labtel-urjc/ardusense/ArduSense PCB Design/ArduSense_V0_3_5.brd

## EAGLE design ArduSense PCB Design/ArduSense_V0_3_5.brd (2018-04-27)

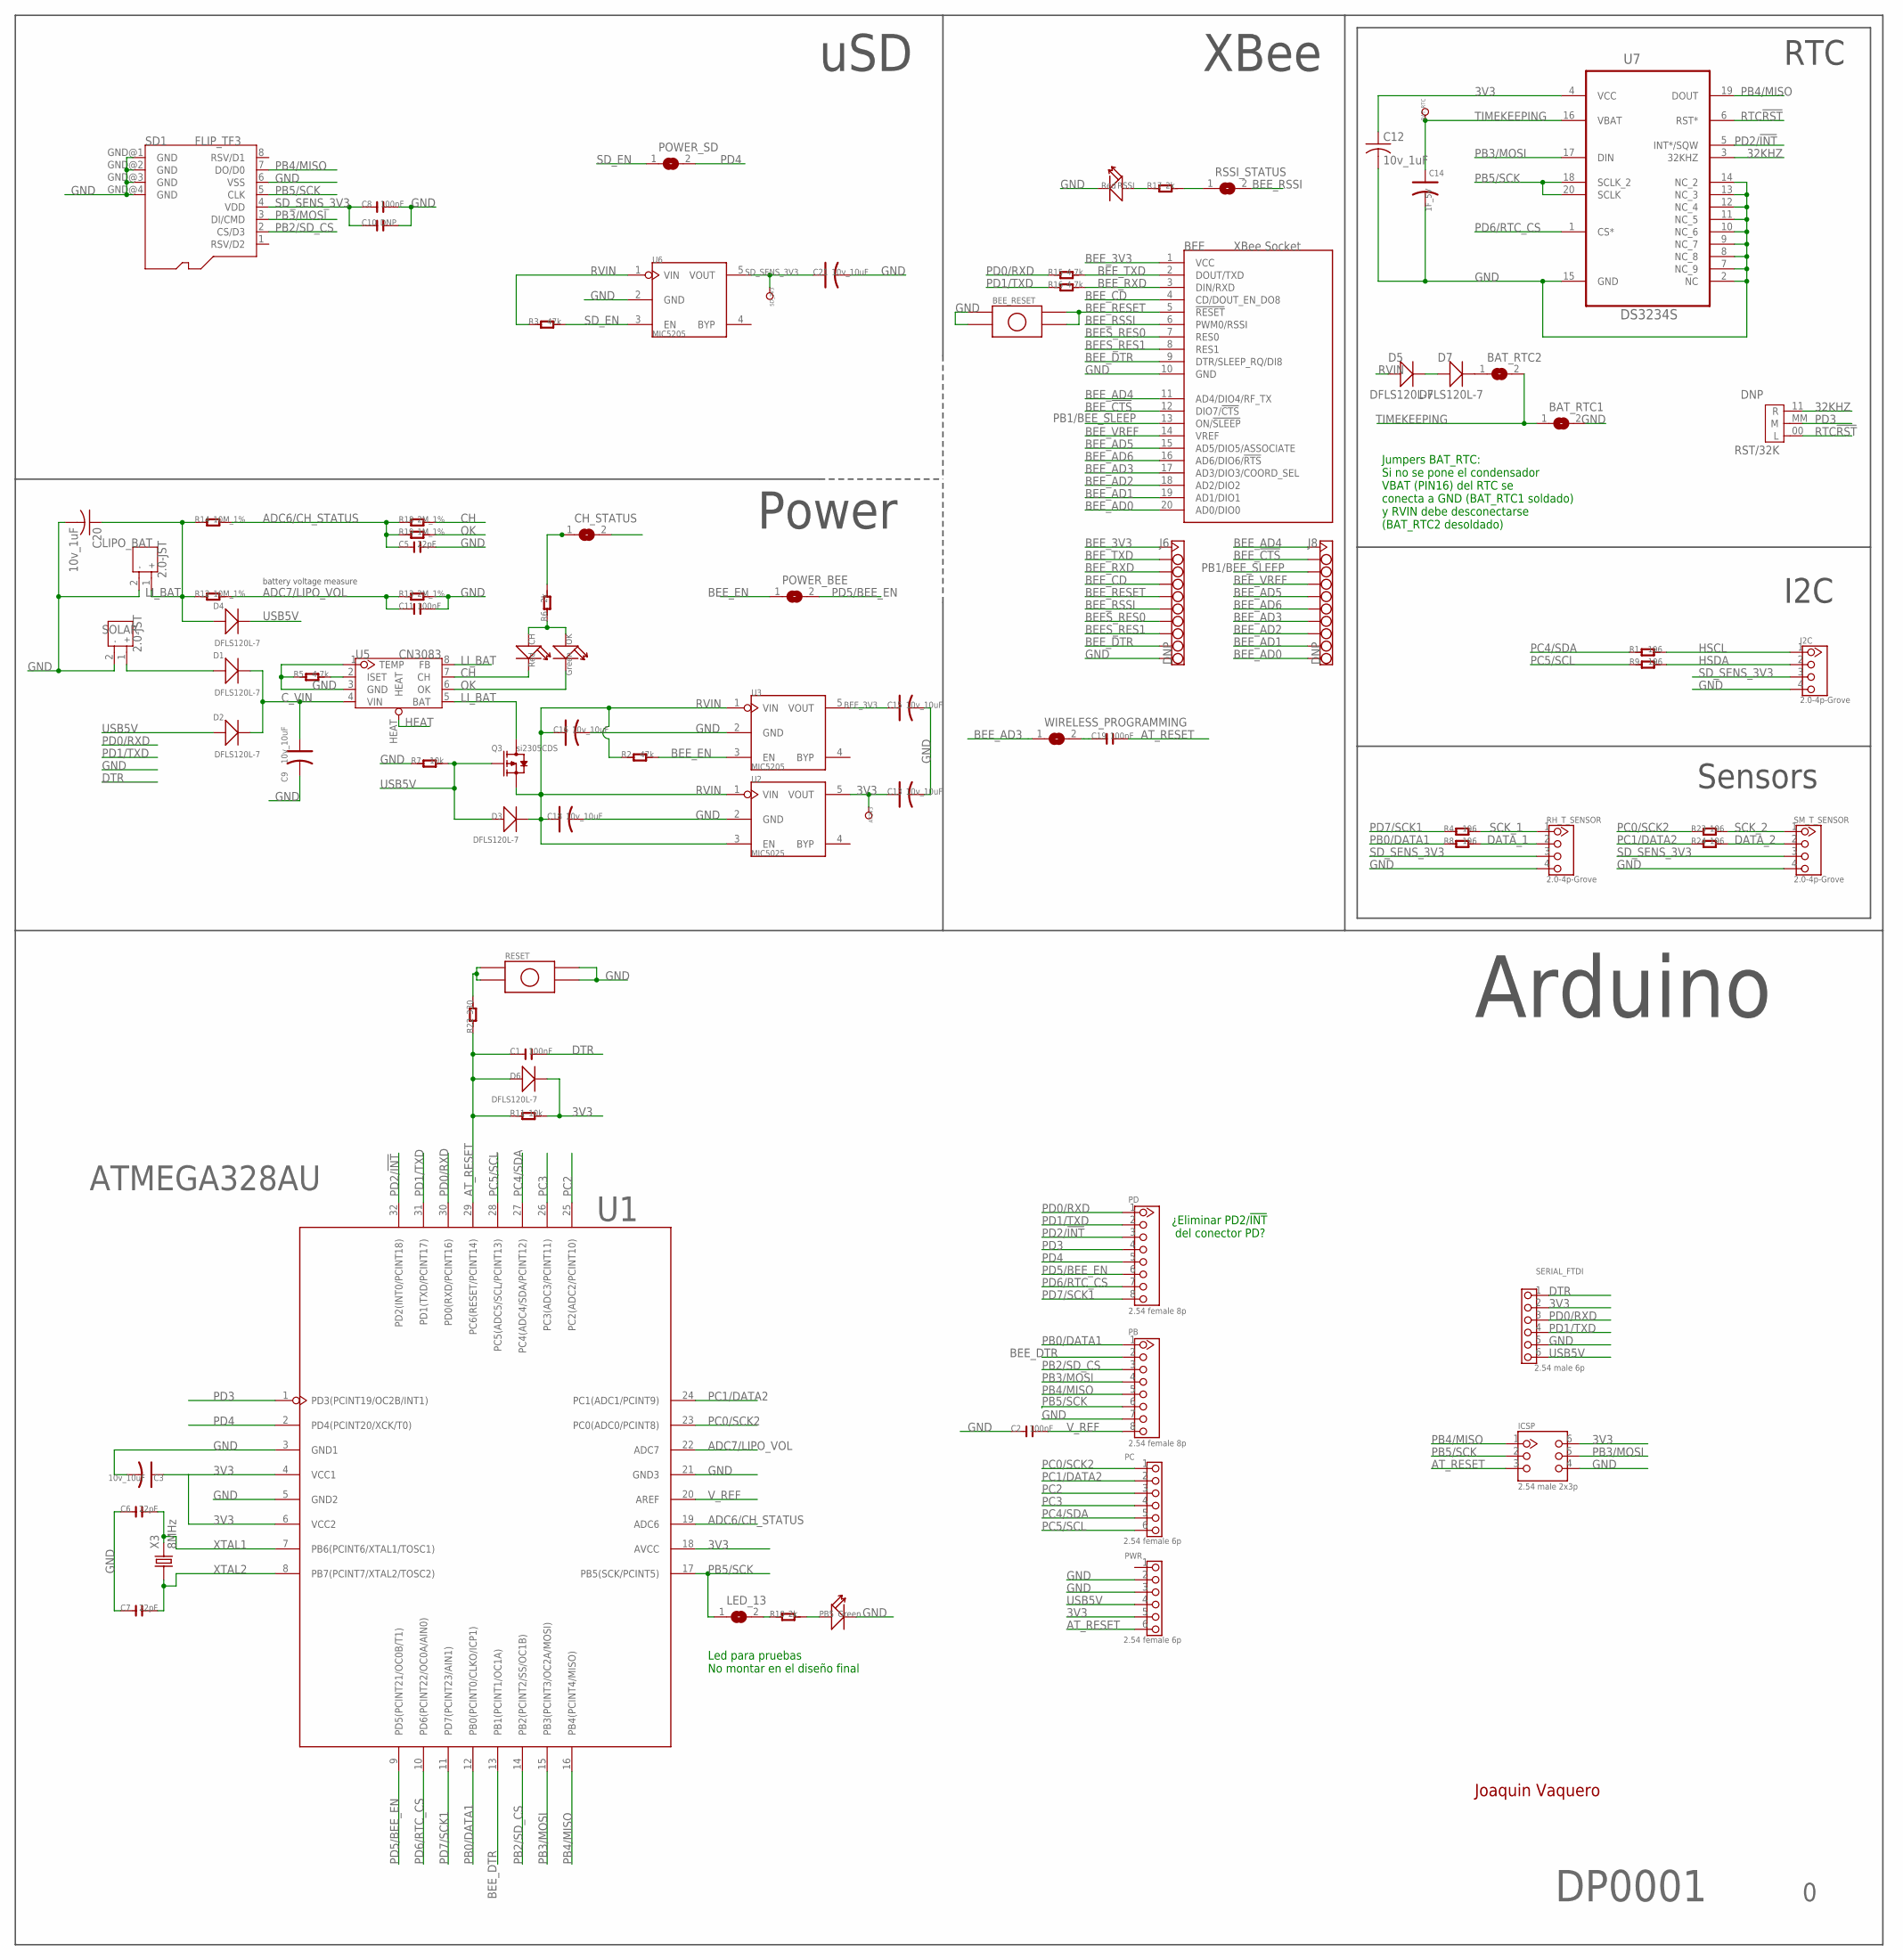
[picture p1: schematic ArduSense_V0_3_5.sch]

Parts:
AT3V3: DNP; TP_3535
BAT_RTC: DNP; TP_3535
BAT_RTC1, BAT_RTC2: SJ
BEE: XBee Socket; BEE
BEE_RESET: PUSH_BUTTON; PBUTTON_SMD
C1, C2, C8, C11, C19: 100nF; C1206
C3, C9, C13, C15, C16, C18, C21: 10v_10uF; AVX-A
C5, C6, C7: 22pF; C1206
C10: DNP; C1206
C12, C20: 10v_1uF; C0805
C14: 1F_5V; EB21,5D
CH: Red; D1206
CH_STATUS: SJ
D1, D2, D3, D4, D5, D6, D7: DFLS120L-7; POWERDI123
I2C: 2.0-4p-Grove; 4P-2.0
ICSP: 2.54 male 2x3p; 2X3P-2.54-LEADED
J6, J8: DNP; HEADER_1X10
LED_13: SJ
LIPO_BAT: 2.0-JST; JST-2.0
OK: Green; D1206
PB: 2.54 female 8p; 8P-2.54-LEADED
PB5: Green; D1206
PC: 2.54 female 6p; 6P-2.54-LEADED
PD: 2.54 female 8p; 8P-2.54-LEADED
POWER_BEE: SJ
POWER_SD: SJ
PWR: 2.54 female 6p; 6P-2.54-LEADED
Q3: si2305CDS; SOT23
R1, R4, R8, R9, R23, R24: 196; R1206
R2, R3: 47k; R1206
R5, R15, R16: 4.7k; R1206
R6, R10, R17: 2k; R1206
R7, R11: 10k; R1206
R12, R14: 10M_1%; R1206
R13, R18: 2M_1%; R1206
R19: 1M_1%; R1206
R22: 330; R1206
RESET: PUSH_BUTTON; PBUTTON_SMD
RH_T_SENSOR: 2.0-4p-Grove; 4P-2.0
RSSI: Red; D1206
RSSI_STATUS: SJ
RST/32K: DNP; JUMPER
SD1: FLIP_TF3
SD_3V3: DNP; TP_3535
SERIAL_FTDI: 2.54 male 6p; 6P-2.54-LEADED
SM_T_SENSOR: 2.0-4p-Grove; 4P-2.0
SOLAR: 2.0-JST; JST-2.0
U1: ATMEGA328AU; ATMEGA168-20AU
U2: MIC5025; SOT23-5
U3, U6: MIC5205; SOT23-5
U5: CN3083; SOP8
U7: DS3234S; SOIC127P1032X265-20N
WIRELESS_PROGRAMMING: SJ
X3: 8MHz; HC49UP

Connections:
3V3: AT3V3.T, C3.+ (1), C12.1, C13.+ (1), D6.-, ICSP.6, PWR.5, R11.2, SERIAL_FTDI.2, U1.4 (VCC1), U1.6 (VCC2), U1.18 (AVCC), U2.5 (VOUT), U7.4 (VCC)
32KHZ: RST/32K.11 (R), U7.3 (32KHZ)
ADC6/CH_STATUS: C5.1, R14.2, R18.1, R19.1, U1.19 (ADC6)
ADC7/LIPO_VOL: C11.1, R12.2, R13.1, U1.22 (ADC7)
AT_RESET: C1.1, C19.2, D6.+, ICSP.3, PWR.6, R11.1, R22.1, U1.29 (PC6(RESET/PCINT14))
BEES_RES0: BEE.7 (RES0), J6.7
BEES_RES1: BEE.8 (RES1), J6.8
BEE_3V3: BEE.1 (VCC), C15.+ (1), J6.1, U3.5 (VOUT)
BEE_!CTS: BEE.12 (DIO7/!CTS), J8.2
BEE_AD0: BEE.20 (AD0/DIO0), J8.10
BEE_AD1: BEE.19 (AD1/DIO1), J8.9
BEE_AD2: BEE.18 (AD2/DIO2), J8.8
BEE_AD3: BEE.17 (AD3/DIO3/COORD_SEL), J8.7, WIRELESS_PROGRAMMING.1
BEE_AD4: BEE.11 (AD4/DIO4/RF_TX), J8.1
BEE_AD5: BEE.15 (AD5/DIO5/ASSOCIATE), J8.5
BEE_AD6: BEE.16 (AD6/DIO6/!RTS), J8.6
BEE_CD: BEE.4 (CD/DOUT_EN_DO8), J6.4
BEE_DTR: BEE.9 (DTR/SLEEP_RQ/DI8), J6.9, PB.2, U1.13 (PB1(PCINT1/OC1A))
BEE_EN: POWER_BEE.1, R2.2, U3.3 (EN)
BEE_RESET: BEE.5 (!RESET), BEE_RESET.3, BEE_RESET.4, J6.5
BEE_RSSI: BEE.6 (PWM0/RSSI), J6.6, RSSI_STATUS.2
BEE_RXD: BEE.3 (DIN/RXD), J6.3, R16.2
BEE_TXD: BEE.2 (DOUT/TXD), J6.2, R15.2
BEE_VREF: BEE.14 (VREF), J8.4
CH: CH.-, R18.2, U5.7 (CH)
C_VIN: C9.+ (1), CH_STATUS.2, D1.-, D2.-, U5.4 (VIN)
DATA_1: R8.2, RH_T_SENSOR.2
DATA_2: R24.2, SM_T_SENSOR.2
DTR: C1.2, SERIAL_FTDI.1
GND: BAT_RTC1.2, BEE.10 (GND), BEE_RESET.1, BEE_RESET.2, C2.1, C3.- (2), C5.2, C6.1, C7.1, C8.2, C9.- (2), C10.2, C11.2, C12.6+ (2), C13.- (2), C14.- (2), C15.- (2), C16.- (2), C18.- (2), C20.6+ (2), C21.- (2), I2C.4, ICSP.4, J6.10, LIPO_BAT.2, PB.7, PB5.-, PWR.2, PWR.3, R5.1, R7.1, R13.2, RESET.3, RESET.4, RH_T_SENSOR.4, RSSI.-, SD1.6 (VSS), SD1.GND@1 (GND), SD1.GND@2 (GND), SD1.GND@3 (GND), SD1.GND@4 (GND), SERIAL_FTDI.5, SM_T_SENSOR.4, SOLAR.2, U1.3 (GND1), U1.5 (GND2), U1.21 (GND3), U2.2 (GND), U3.2 (GND), U5.1 (TEMP), U5.3 (GND), U6.2 (GND), U7.2 (NC), U7.7 (NC_9), U7.8 (NC_8), U7.9 (NC_7), U7.10 (NC_6), U7.11 (NC_5), U7.12 (NC_4), U7.13 (NC_3), U7.14 (NC_2), U7.15 (GND)
HEAT: U5.HEAT
HSCL: I2C.1, R1.2
HSDA: I2C.2, R9.2
LI_BAT: C20.1, D4.+, LIPO_BAT.1, Q3.3 (D), R12.1, R14.1, U5.5 (BAT), U5.8 (FB)
unnamed: PB5.+, R10.2
unnamed: D5.-, D7.+
unnamed: D1.+, SOLAR.1
unnamed: R22.2, RESET.1, RESET.2
unnamed: R5.2, U5.2 (ISET)
unnamed: R17.1, RSSI.+
unnamed: R17.2, RSSI_STATUS.1
unnamed: CH.+, OK.+, R6.1
unnamed: BAT_RTC2.1, D7.-
unnamed: C19.1, WIRELESS_PROGRAMMING.2
unnamed: LED_13.2, R10.1
unnamed: CH_STATUS.1, R6.2
OK: OK.-, R19.2, U5.6 (OK)
PB0/DATA1: PB.1, R8.1, U1.12 (PB0(PCINT0/CLKO/ICP1))
PB1/BEE_SLEEP: BEE.13 (ON/!SLEEP), J8.3
PB2/SD_CS: PB.3, SD1.2 (CS/D3), U1.14 (PB2(PCINT2/SS/OC1B))
PB3/MOSI: ICSP.5, PB.4, SD1.3 (DI/CMD), U1.15 (PB3(PCINT3/OC2A/MOSI)), U7.17 (DIN)
PB4/MISO: ICSP.1, PB.5, SD1.7 (DO/D0), U1.16 (PB4(PCINT4/MISO)), U7.19 (DOUT)
PB5/SCK: ICSP.2, LED_13.1, PB.6, SD1.5 (CLK), U1.17 (PB5(SCK/PCINT5)), U7.18 (SCLK_2), U7.20 (SCLK)
PC0/SCK2: PC.1, R23.1, U1.23 (PC0(ADC0/PCINT8))
PC1/DATA2: PC.2, R24.1, U1.24 (PC1(ADC1/PCINT9))
PC2: PC.3, U1.25 (PC2(ADC2/PCINT10))
PC3: PC.4, U1.26 (PC3(ADC3/PCINT11))
PC4/SDA: PC.5, R1.1, U1.27 (PC4(ADC4/SDA/PCINT12))
PC5/SCL: PC.6, R9.1, U1.28 (PC5(ADC5/SCL/PCINT13))
PD0/RXD: PD.1, R15.1, SERIAL_FTDI.3, U1.30 (PD0(RXD/PCINT16))
PD1/TXD: PD.2, R16.1, SERIAL_FTDI.4, U1.31 (PD1(TXD/PCINT17))
PD2/!INT: PD.3, U1.32 (PD2(INT0/PCINT18)), U7.5 (INT*/SQW)
PD3: PD.4, RST/32K.MM (M), U1.1 (PD3(PCINT19/OC2B/INT1))
PD4: PD.5, POWER_SD.2, U1.2 (PD4(PCINT20/XCK/T0))
PD5/BEE_EN: PD.6, POWER_BEE.2, U1.9 (PD5(PCINT21/OC0B/T1))
PD6/RTC_CS: PD.7, U1.10 (PD6(PCINT22/OC0A/AIN0)), U7.1 (CS*)
PD7/SCK1: PD.8, R4.1, U1.11 (PD7(PCINT23/AIN1))
RTC!RST: RST/32K.00 (L), U7.6 (RST*)
RVIN: C16.+ (1), C18.+ (1), D3.-, D5.+, Q3.2 (S), R2.1, R3.1, U2.1 (VIN), U2.3 (EN), U3.1 (VIN), U6.1 (VIN)
SCK_1: R4.2, RH_T_SENSOR.1
SCK_2: R23.2, SM_T_SENSOR.1
SD_EN: POWER_SD.1, R3.2, U6.3 (EN)
SD_SENS_3V3: C8.1, C10.1, C21.+ (1), I2C.3, RH_T_SENSOR.3, SD1.4 (VDD), SD_3V3.T, SM_T_SENSOR.3, U6.5 (VOUT)
TIMEKEEPING: BAT_RTC.T, BAT_RTC1.1, BAT_RTC2.2, C14.+ (1), U7.16 (VBAT)
USB5V: D2.+, D3.+, D4.-, PWR.4, Q3.1 (G), R7.2, SERIAL_FTDI.6
V_REF: C2.2, PB.8, U1.20 (AREF)
XTAL1: C6.2, U1.7 (PB6(PCINT6/XTAL1/TOSC1)), X3.2
XTAL2: C7.2, U1.8 (PB7(PCINT7/XTAL2/TOSC2)), X3.1

Notes on the sheet:
Power
Arduino
uSD
XBee
battery voltage measure
RTC
I2C
DP0001
Jumpers BAT_RTC: Si no se pone el condensador VBAT (PIN16) del RTC se conecta a GND (BAT_RTC1 soldado) y RVIN debe desconectarse (BAT_RTC2 desoldado)
Led para pruebas No montar en el diseño final
¿Eliminar PD2/!INT del conector PD?
Sensors

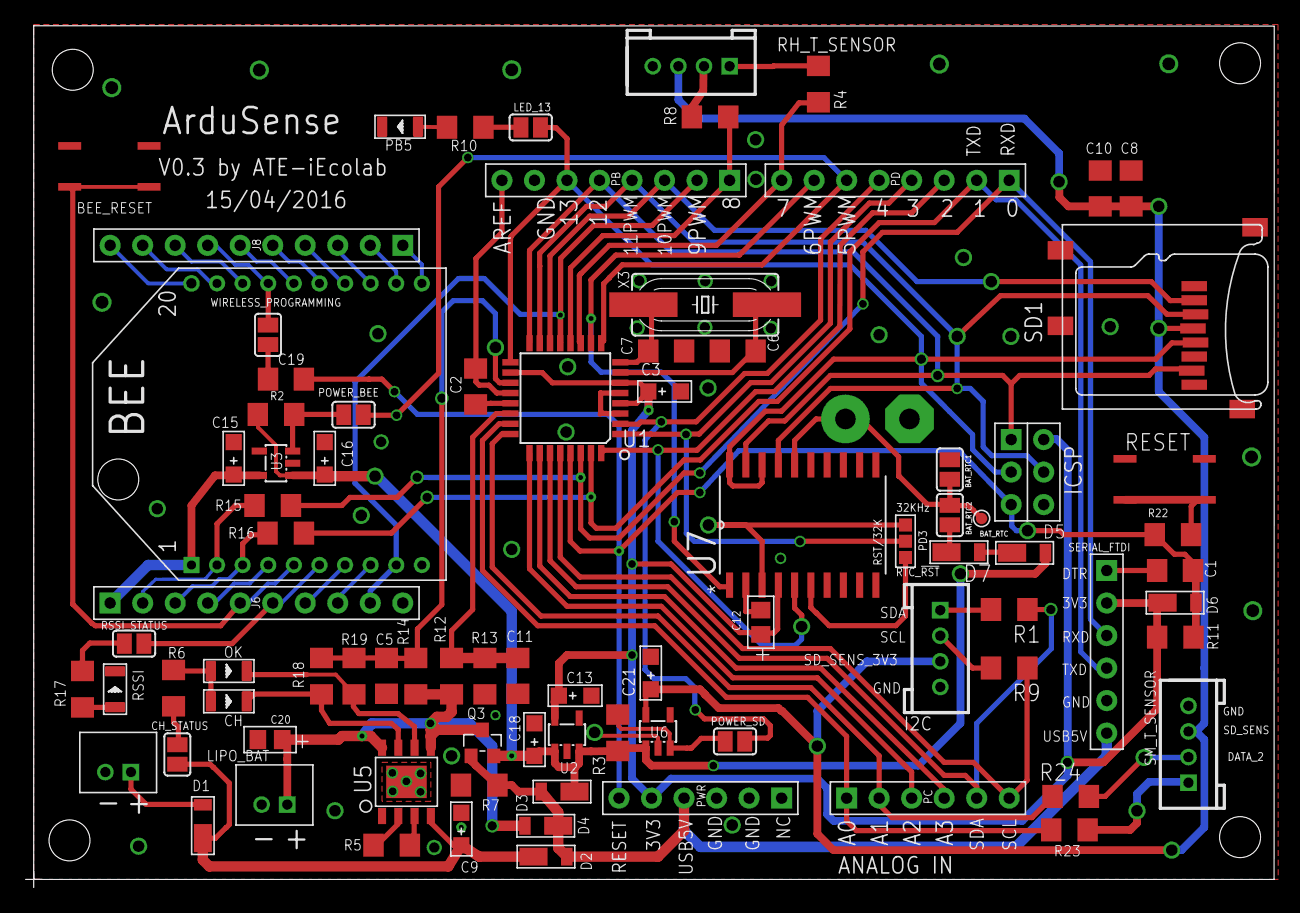
[picture p2: board ArduSense_V0_3_5.brd from above]

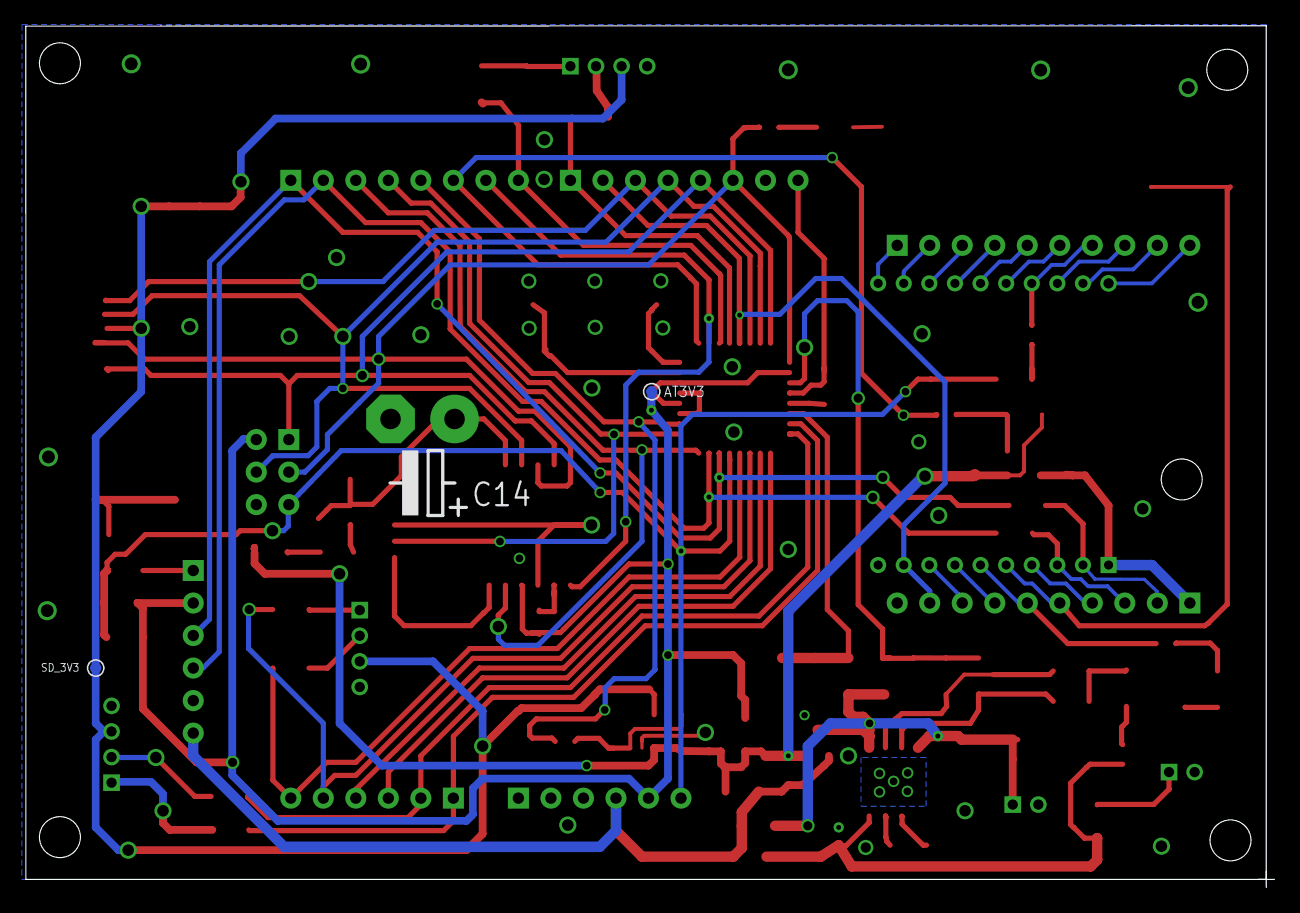
[picture p3: board ArduSense_V0_3_5.brd from below]

Board: 2 copper layers, 97.5 x 67.3 mm, 89 parts (3 on the bottom side), 77 nets.
