labtel-urjc/ardusense/(commit log)

2018-04-18 Ardusense (arduino) source code
2018-04-18 Revert "Ardusense (arduino) source code"
    This reverts commit 2904e3d80fec815b0102ec733556d5e6e0abcc89.
2018-04-18 source code
    Source code ardusense/arduino
2018-04-27 PCB Test Examples
2018-04-27 Ardusense PCB Design
    [ArduSense_V0_3_5.brd, ArduSense_V0_3_5.sch]
2018-07-04 añadimos funciones RSSI
    Control de intensidad de señal de comunicaciones
2018-07-04 Cambios RSSI
    Control de intensidad de señal comunicaciones
2018-07-04 cambios finales
    Cambios finales en el código
